xXIOSCARIXx/Web-controlled-RC-car/Showcase/Car.jpg

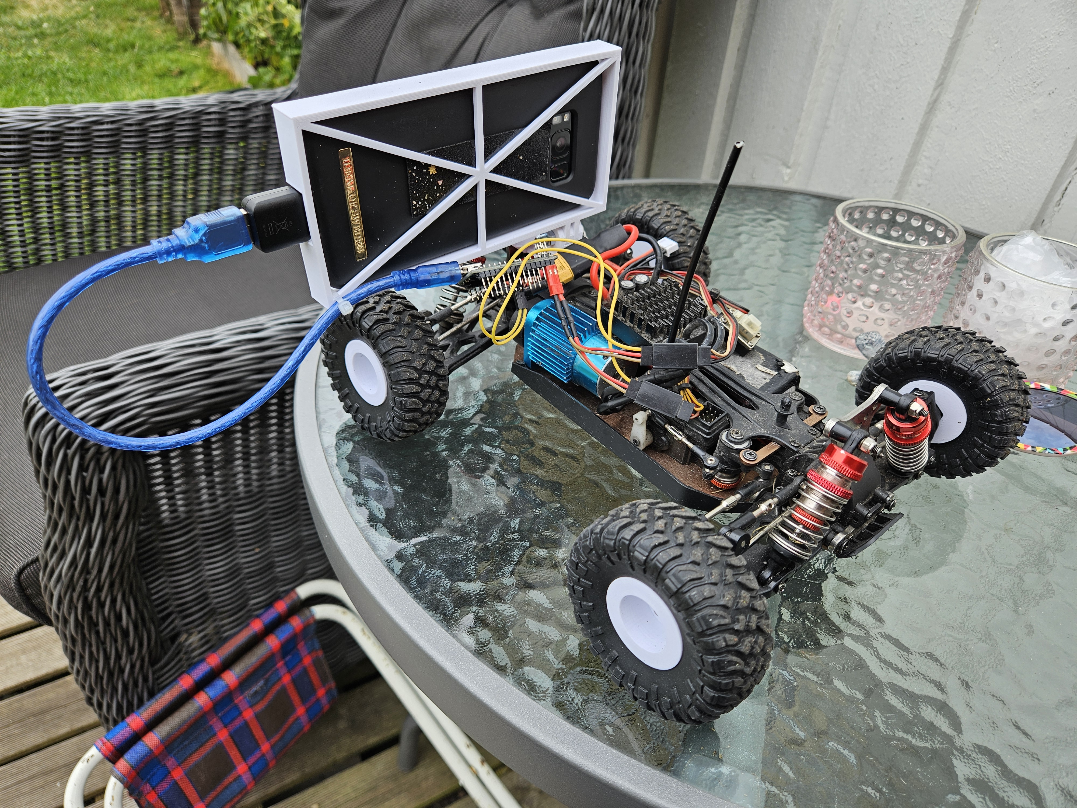
Showcase/Car.jpg
