xXIOSCARIXx/Web-controlled-RC-car/Showcase/UI.jpg

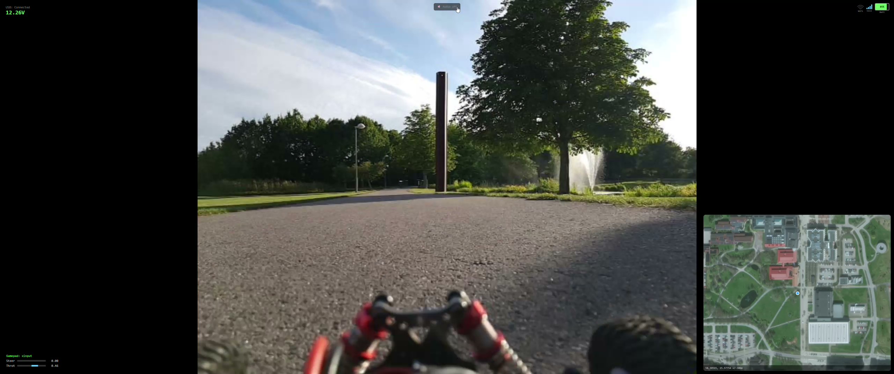
Showcase/UI.jpg
