xXIOSCARIXx/Web-controlled-RC-car/RoverLink/app/src/main/java/com/roverlink/MainService.kt

package com.roverlink

import android.annotation.SuppressLint
import android.util.Range
import android.app.Notification
import android.app.NotificationChannel
import android.app.NotificationManager
import android.app.PendingIntent
import android.content.BroadcastReceiver
import android.content.Context
import android.content.Intent
import android.content.IntentFilter
import android.content.pm.ServiceInfo
import android.view.Surface
import android.hardware.usb.UsbDevice
import android.media.*
import android.hardware.usb.UsbManager
import android.location.Location
import android.net.wifi.WifiManager
import android.os.*
import android.net.ConnectivityManager
import android.net.TrafficStats
import android.net.NetworkCapabilities
import android.net.wifi.WifiInfo
import android.telephony.TelephonyCallback
import android.telephony.SignalStrength
import android.telephony.TelephonyManager
import androidx.camera.camera2.interop.Camera2CameraControl
import androidx.camera.camera2.interop.CaptureRequestOptions
import android.hardware.camera2.CaptureRequest
import androidx.camera.camera2.interop.ExperimentalCamera2Interop
import androidx.camera.core.Camera
import android.util.Size
import androidx.camera.core.CameraSelector
import androidx.camera.core.Preview
import androidx.camera.core.resolutionselector.ResolutionSelector
import androidx.camera.core.resolutionselector.ResolutionStrategy
import androidx.camera.lifecycle.ProcessCameraProvider
import androidx.core.app.NotificationCompat
import androidx.core.content.ContextCompat
import androidx.lifecycle.Lifecycle
import androidx.lifecycle.LifecycleService
import com.google.android.gms.location.FusedLocationProviderClient
import com.google.android.gms.location.LocationCallback
import com.google.android.gms.location.LocationRequest
import com.google.android.gms.location.LocationResult
import com.google.android.gms.location.LocationServices
import com.google.android.gms.location.Priority
import com.hoho.android.usbserial.driver.UsbSerialProber
import okhttp3.OkHttpClient
import okhttp3.Request
import okhttp3.Response
import okhttp3.WebSocket
import okhttp3.WebSocketListener
import okio.ByteString.Companion.toByteString
import org.json.JSONObject
import java.security.KeyStore
import java.security.cert.CertificateFactory
import java.util.concurrent.Executors
import java.util.concurrent.atomic.AtomicReference
import javax.net.ssl.SSLContext
import javax.net.ssl.TrustManagerFactory
import javax.net.ssl.X509TrustManager
import kotlin.math.roundToInt

@androidx.annotation.OptIn(ExperimentalCamera2Interop::class)
class MainService : LifecycleService() {

    private val binder = LocalBinder()
    private var wakeLock: PowerManager.WakeLock? = null

    var wsStatus = "WSS: Connecting..."
        private set
    var usbStatus = "USB: Disconnected"
        private set
    var steerDisplay = 0f
        private set
    var throttleDisplay = 0f
        private set
    var isStreaming = false
        private set

    @Volatile
    private var wasWsConnected = false
    private val appStartTime = SystemClock.uptimeMillis()
    private val statusDelayHandler = Handler(Looper.getMainLooper())
    private var onStatusChanged: (() -> Unit)? = null

    private val batteryReceiver = object : BroadcastReceiver() {
        override fun onReceive(context: Context, intent: Intent) {
            val level = intent.getIntExtra(BatteryManager.EXTRA_LEVEL, -1)
            val scale = intent.getIntExtra(BatteryManager.EXTRA_SCALE, -1)
            val status = intent.getIntExtra(BatteryManager.EXTRA_STATUS, -1)
            val isCharging = status == BatteryManager.BATTERY_STATUS_CHARGING ||
                    status == BatteryManager.BATTERY_STATUS_FULL

            if ((level != -1) && (scale != -1)) {
                val pct = ((level * 100f) / scale).roundToInt()
                webSocket?.send("""{"type":"battery","level":$pct,"charging":$isCharging}""")
            }
        }
    }

    private var wifiLevel = 0
    private var cellLevel = 0
    private var lastUidRx = 0L
    private var lastUidTx = 0L
    private var dataRxSinceStart = 0L
    private var dataTxSinceStart = 0L
    private var signalThread: HandlerThread? = null
    private var signalHandler: Handler? = null
    private val signalRunnable = object : Runnable {
        override fun run() {
            updateSignalInfo()
            updateDataUsage()
            signalHandler?.postDelayed(this, 5000)
        }
    }

    private fun updateDataUsage() {
        val currentRx = TrafficStats.getUidRxBytes(Process.myUid())
        val currentTx = TrafficStats.getUidTxBytes(Process.myUid())
        
        if (currentRx != TrafficStats.UNSUPPORTED.toLong() && currentTx != TrafficStats.UNSUPPORTED.toLong()) {
            if (lastUidRx > 0 || lastUidTx > 0) {
                val deltaRx = if (currentRx >= lastUidRx) currentRx - lastUidRx else 0L
                val deltaTx = if (currentTx >= lastUidTx) currentTx - lastUidTx else 0L
                
                val cm = getSystemService(CONNECTIVITY_SERVICE) as ConnectivityManager
                val network = cm.activeNetwork
                val caps = cm.getNetworkCapabilities(network)
                if (caps != null && (caps.hasTransport(NetworkCapabilities.TRANSPORT_CELLULAR) || 
                    caps.hasTransport(NetworkCapabilities.TRANSPORT_WIFI))) {
                    dataRxSinceStart += deltaRx
                    dataTxSinceStart += deltaTx
                }
            }
            lastUidRx = currentRx
            lastUidTx = currentTx
        }
        
        webSocket?.send("""{"type":"data_usage","data_rx":$dataRxSinceStart,"data_tx":$dataTxSinceStart}""")
    }

    private fun updateSignalInfo() {
        val wm = getSystemService(WIFI_SERVICE) as WifiManager
        val cm = getSystemService(CONNECTIVITY_SERVICE) as ConnectivityManager
        val network = cm.activeNetwork
        val caps = cm.getNetworkCapabilities(network)
        if ((caps != null) && caps.hasTransport(NetworkCapabilities.TRANSPORT_WIFI)) {
            val wifiInfo = if (Build.VERSION.SDK_INT >= Build.VERSION_CODES.S) {
                caps.transportInfo as? WifiInfo
            } else {
                @Suppress("DEPRECATION")
                wm.connectionInfo
            }
            if (wifiInfo != null) {
                wifiLevel = if (Build.VERSION.SDK_INT >= Build.VERSION_CODES.R) {
                    wm.calculateSignalLevel(wifiInfo.rssi)
                } else {
                    @Suppress("DEPRECATION")
                    WifiManager.calculateSignalLevel(wifiInfo.rssi, 5)
                }
                webSocket?.send("""{"type":"wifi","level":$wifiLevel}""")
            }
        } else {
            wifiLevel = 0
        }
    }

    private val telephonyCallback = if (Build.VERSION.SDK_INT >= Build.VERSION_CODES.S) {
        object : TelephonyCallback(), TelephonyCallback.SignalStrengthsListener {
            @Deprecated("Deprecated in Java")
            override fun onSignalStrengthsChanged(signalStrength: SignalStrength) {
                updateSignalLevel(signalStrength)
            }
        }
    } else null

    private val phoneStateListener = if (Build.VERSION.SDK_INT < Build.VERSION_CODES.S) {
        @Suppress("DEPRECATION")
        object : android.telephony.PhoneStateListener() {
            @Deprecated("Deprecated in Java")
            override fun onSignalStrengthsChanged(signalStrength: SignalStrength) {
                updateSignalLevel(signalStrength)
            }
        }
    } else null

    private fun updateSignalLevel(signalStrength: SignalStrength) {
        val level = if (Build.VERSION.SDK_INT >= Build.VERSION_CODES.Q) {
            signalStrength.level
        } else {
            try {
                val getLevel = SignalStrength::class.java.getMethod("getLevel")
                getLevel.invoke(signalStrength) as Int
            } catch (_: Exception) {
                0
            }
        }
        cellLevel = level
        webSocket?.send("""{"type":"cell","level":$cellLevel}""")
    }

    @Volatile
    private var webSocket: WebSocket? = null
    private val client by lazy { buildTrustedClient() }
    private var serverIp = ""
    private val reconnectHandler = Handler(Looper.getMainLooper())
    private val usbReconnectHandler = Handler(Looper.getMainLooper())

    @Volatile
    private var serial: UsbCdcSerial? = null
    private val usbLock = Any()
    private val usbReadExecutor = Executors.newSingleThreadExecutor { r ->
        Thread(r, "UsbReadThread").apply { priority = Thread.MAX_PRIORITY }
    }
    private val usbWriteExecutor = Executors.newSingleThreadExecutor { r ->
        Thread(r, "UsbWriteThread").apply { priority = Thread.MAX_PRIORITY }
    }
    private var lastSteerValue = -1
    private var lastThrottleValue = -1
    private var lastDriveSentAt = 0L
    private val pendingDrive = AtomicReference<Triple<Float, Float, Float>?>()

    private val usbReceiver = object : BroadcastReceiver() {
        override fun onReceive(context: Context, intent: Intent) {
            when (intent.action) {
                ACTION_USB_PERMISSION -> {
                    val granted = intent.getBooleanExtra(UsbManager.EXTRA_PERMISSION_GRANTED, false)
                    if (granted) connectUsb() else updateUsbStatus("USB: Permission denied")
                }
                UsbManager.ACTION_USB_DEVICE_ATTACHED -> connectUsb()
                UsbManager.ACTION_USB_DEVICE_DETACHED -> {
                    val device = if (Build.VERSION.SDK_INT >= Build.VERSION_CODES.TIRAMISU) {
                        intent.getParcelableExtra(UsbManager.EXTRA_DEVICE, UsbDevice::class.java)
                    } else {
                        @Suppress("DEPRECATION")
                        intent.getParcelableExtra(UsbManager.EXTRA_DEVICE)
                    }
                    if ((device == null) || (device.deviceName == (serial?.deviceName ?: "")))
                        closeSerial("USB: Disconnected")
                }
            }
        }
    }

    private lateinit var fusedLocationClient: FusedLocationProviderClient
    private lateinit var locationFilter: LocationFilter
    private var currentBestLocation: Location? = null
    private val locationCallback = object : LocationCallback() {
        override fun onLocationResult(result: LocationResult) {
            val loc: Location = result.lastLocation ?: return
            if (isBetterLocation(loc, currentBestLocation)) {
                currentBestLocation = loc
                val filteredLoc = locationFilter.filter(loc)
                val ws = webSocket ?: return
                val payload = """{"type":"gps","lat":${filteredLoc.latitude},"lng":${filteredLoc.longitude},"acc":${filteredLoc.accuracy}}"""
                ws.send(payload)
            }
        }
    }

    private fun isBetterLocation(location: Location, currentBestLocation: Location?): Boolean {
        if (currentBestLocation == null) {
            return true
        }

        val timeDelta: Long = location.time - currentBestLocation.time
        val isSignificantlyNewer: Boolean = timeDelta > TWO_MINUTES
        val isSignificantlyOlder: Boolean = timeDelta < -TWO_MINUTES
        val isNewer: Boolean = timeDelta > 0

        if (isSignificantlyNewer) {
            return true
        } else if (isSignificantlyOlder) {
            return false
        }

        val accuracyDelta: Int = (location.accuracy - currentBestLocation.accuracy).toInt()
        val isLessAccurate: Boolean = accuracyDelta > 0
        val isMoreAccurate: Boolean = accuracyDelta < 0
        val isSignificantlyLessAccurate: Boolean = accuracyDelta > 200

        val isFromSameProvider: Boolean = location.provider == currentBestLocation.provider

        if (isMoreAccurate) {
            return true
        } else if (isNewer && !isLessAccurate) {
            return true
        } else if (isNewer && !isSignificantlyLessAccurate && isFromSameProvider) {
            return true
        }
        return false
    }

    private var cameraProvider: ProcessCameraProvider? = null
    private var activeCamera: Camera? = null
    private val cameraExecutor = Executors.newSingleThreadExecutor { r ->
        Thread(r, "CameraFrameThread").apply { priority = Thread.MAX_PRIORITY }
    }
    private var useFrontCamera = false

    private var audioEnabled = false
    private var torchEnabled = false
    private var isAlarmPlaying = false

    @Volatile
    private var isShuttingDown = false

    private var videoEncoder: MediaCodec? = null
    private var inputSurface: Surface? = null
    private var encoderWidth = 960
    private var encoderHeight = 720
    private var configBuffer: ByteArray? = null
    private val videoEncoderLock = Any()

    private var audioRecord: AudioRecord? = null
    private var audioThread: Thread? = null
    @Volatile
    private var isAudioRunning = false

    private var mediaPlayer: MediaPlayer? = null
    private var honkPlayer: MediaPlayer? = null

    inner class LocalBinder : Binder() {
        fun getService(): MainService = this@MainService
    }

    override fun onBind(intent: Intent): IBinder {
        super.onBind(intent)
        return binder
    }

    override fun onCreate() {
        super.onCreate()
        lastUidRx = TrafficStats.getUidRxBytes(Process.myUid())
        lastUidTx = TrafficStats.getUidTxBytes(Process.myUid())
        if (lastUidRx == TrafficStats.UNSUPPORTED.toLong()) lastUidRx = 0
        if (lastUidTx == TrafficStats.UNSUPPORTED.toLong()) lastUidTx = 0

        createNotificationChannel()
        val initialStatus = "$wsStatus | CAM: Standby"
        if (Build.VERSION.SDK_INT >= Build.VERSION_CODES.UPSIDE_DOWN_CAKE) {
            startForeground(
                NOTIFICATION_ID,
                createNotification(initialStatus),
                ServiceInfo.FOREGROUND_SERVICE_TYPE_CAMERA or
                        ServiceInfo.FOREGROUND_SERVICE_TYPE_LOCATION or
                        ServiceInfo.FOREGROUND_SERVICE_TYPE_CONNECTED_DEVICE or
                        ServiceInfo.FOREGROUND_SERVICE_TYPE_MICROPHONE,
            )
        } else {
            startForeground(NOTIFICATION_ID, createNotification(initialStatus))
        }

        val pm = getSystemService(POWER_SERVICE) as PowerManager
        wakeLock = pm.newWakeLock(PowerManager.PARTIAL_WAKE_LOCK, "Scout::WakeLock").apply {
            acquire(24 * 60 * 60 * 1000L)
        }

        fusedLocationClient = LocationServices.getFusedLocationProviderClient(this)
        locationFilter = LocationFilter()

        val tm = getSystemService(TELEPHONY_SERVICE) as TelephonyManager
        if (Build.VERSION.SDK_INT >= Build.VERSION_CODES.S) {
            telephonyCallback?.let { tm.registerTelephonyCallback(mainExecutor, it) }
        } else {
            @Suppress("DEPRECATION")
            tm.listen(phoneStateListener, android.telephony.PhoneStateListener.LISTEN_SIGNAL_STRENGTHS)
        }
        signalThread = HandlerThread("SignalThread").apply { start() }
        signalHandler = Handler(signalThread!!.looper)
        signalHandler?.post(signalRunnable)

        val filter = IntentFilter(ACTION_USB_PERMISSION).apply {
            addAction(UsbManager.ACTION_USB_DEVICE_ATTACHED)
            addAction(UsbManager.ACTION_USB_DEVICE_DETACHED)
        }
        ContextCompat.registerReceiver(this, usbReceiver, filter, ContextCompat.RECEIVER_NOT_EXPORTED)
        registerReceiver(batteryReceiver, IntentFilter(Intent.ACTION_BATTERY_CHANGED))
    }

    override fun onStartCommand(intent: Intent?, flags: Int, startId: Int): Int {
        val newIp = intent?.getStringExtra("server_ip") ?: ""
        if (newIp.isNotEmpty() && (newIp != serverIp)) {
            serverIp = newIp
            startStreaming()
        }
        connectUsb()
        startLocationUpdates()
        return super.onStartCommand(intent, flags, startId)
    }

    fun setStatusListener(listener: (() -> Unit)?) {
        onStatusChanged = listener
    }

    private fun updateWsStatus(status: String) {
        if (wsStatus == status) return
        wsStatus = status
        onStatusChanged?.invoke()
        updateNotification()
    }

    private fun updateUsbStatus(status: String) {
        if (usbStatus == status) return
        usbStatus = status
        onStatusChanged?.invoke()
        updateNotification()
        webSocket?.send("""{"type":"usb_status","status":"$usbStatus"}""")
    }

    private fun updateNotification() {
        val camStatus = if (isStreaming) "CAM: Streaming" else "CAM: Standby"
        val manager = getSystemService(NotificationManager::class.java)
        manager.notify(NOTIFICATION_ID, createNotification("$wsStatus | $camStatus"))
    }

    private fun buildTrustedClient(): OkHttpClient {
        val resId = try { R.raw.cert } catch (_: Exception) { 0 }
        if (resId == 0) {
            return OkHttpClient.Builder()
                .hostnameVerifier { _, _ -> true }
                .build()
        }

        val certInputStream = resources.openRawResource(resId)
        val cf = CertificateFactory.getInstance("X.509")
        val cert = cf.generateCertificate(certInputStream)
        certInputStream.close()
        val keyStore = KeyStore.getInstance(KeyStore.getDefaultType()).apply {
            load(null, null)
            setCertificateEntry("server", cert)
        }
        val tmf = TrustManagerFactory.getInstance(TrustManagerFactory.getDefaultAlgorithm()).apply {
            init(keyStore)
        }
        val sslContext = SSLContext.getInstance("TLS").apply {
            init(null, tmf.trustManagers, null)
        }
        val tm = tmf.trustManagers[0] as X509TrustManager
        return OkHttpClient.Builder()
            .sslSocketFactory(sslContext.socketFactory, tm)
            .hostnameVerifier { _, _ -> true }
            .build()
    }

    private fun startStreaming() {
        reconnectHandler.removeCallbacksAndMessages(null)
        webSocket?.close(1000, null)
        webSocket = null

        if (wsStatus == "WSS: Connected") {
            updateWsStatus("WSS: Connecting...")
        }

        val url = if (serverIp.contains(':')) {
            "wss://$serverIp?role=publisher"
        } else {
            "wss://$serverIp:47291?role=publisher"
        }
        val request = Request.Builder().url(url).build()
        val newSocket = client.newWebSocket(
            request,
            object : WebSocketListener() {
                override fun onOpen(webSocket: WebSocket, response: Response) {
                    wasWsConnected = true
                    statusDelayHandler.removeCallbacksAndMessages(null)
                    Handler(Looper.getMainLooper()).post {
                        updateWsStatus("WSS: Connected")
                        
                        val filter = IntentFilter(Intent.ACTION_BATTERY_CHANGED)
                        val batteryStatus = registerReceiver(null, filter)
                        val bLevel = batteryStatus?.getIntExtra(BatteryManager.EXTRA_LEVEL, -1) ?: -1
                        val bScale = batteryStatus?.getIntExtra(BatteryManager.EXTRA_SCALE, -1) ?: -1
                        val bStatus = batteryStatus?.getIntExtra(BatteryManager.EXTRA_STATUS, -1) ?: -1
                        val isCharging = bStatus == BatteryManager.BATTERY_STATUS_CHARGING ||
                                bStatus == BatteryManager.BATTERY_STATUS_FULL

                        if ((bLevel != -1) && (bScale != -1)) {
                            val pct = ((bLevel * 100f) / bScale).roundToInt()
                            webSocket.send("""{"type":"battery","level":$pct,"charging":$isCharging}""")
                        }
                        
                        updateSignalInfo()
                        updateDataUsage()
                        
                        webSocket.send("""{"type":"usb_status","status":"$usbStatus"}""")
                        
                        webSocket.send("""{"type":"audio_status","enabled":$audioEnabled}""")
                        webSocket.send("""{"type":"torch_status","enabled":$torchEnabled}""")
                        webSocket.send("""{"type":"alarm_status","enabled":$isAlarmPlaying}""")
                    }
                }

                override fun onMessage(webSocket: WebSocket, text: String) {
                    val json = try { JSONObject(text) } catch (_: Exception) { return }
                    when (json.optString("type")) {
                        "viewer_count" -> {
                            val hasViewers = json.optInt("count") > 0
                            Handler(Looper.getMainLooper()).post {
                                if (hasViewers && !isStreaming) {
                                    isStreaming = true
                                    bindCamera()
                                    if (audioEnabled) startAudio()
                                } else if (!hasViewers && isStreaming) {
                                    stopStreamingInternal()
                                }
                                onStatusChanged?.invoke()
                                updateNotification()
                            }
                            return
                        }
                        "toggle_camera" -> {
                            useFrontCamera = !useFrontCamera
                            torchEnabled = false
                            webSocket.send("""{"type":"torch_status","enabled":false}""")
                            Handler(Looper.getMainLooper()).post {
                                if (isStreaming) {
                                    cameraProvider?.unbindAll()
                                    stopVideoEncoder()
                                    bindCamera()
                                }
                            }
                            return
                        }
                        "toggle_audio" -> {
                            audioEnabled = !audioEnabled
                            webSocket.send("""{"type":"audio_status","enabled":$audioEnabled}""")
                            Handler(Looper.getMainLooper()).post {
                                if (isStreaming) {
                                    if (audioEnabled) startAudio() else stopAudio()
                                }
                            }
                            return
                        }
                        "toggle_torch" -> {
                            if (!useFrontCamera) {
                                torchEnabled = !torchEnabled
                                activeCamera?.cameraControl?.enableTorch(torchEnabled)
                                webSocket.send("""{"type":"torch_status","enabled":$torchEnabled}""")
                            } else {
                                torchEnabled = false
                                webSocket.send("""{"type":"torch_status","enabled":false}""")
                            }
                            return
                        }
                        "ping" -> {
                            val ts = json.optLong("ts", 0L)
                            val vid = json.optString("_vid", "")
                            webSocket.send("""{"type":"pong","ts":$ts,"_vid":"$vid"}""")
                            return
                        }
                        "play_alarm" -> {
                            Handler(Looper.getMainLooper()).post { playAlarm() }
                            return
                        }
                        "stop_alarm" -> {
                            Handler(Looper.getMainLooper()).post { stopAlarm() }
                            return
                        }
                        "play_honk" -> {
                            Handler(Looper.getMainLooper()).post { playHonk() }
                            return
                        }
                        "stop_honk" -> {
                            Handler(Looper.getMainLooper()).post { stopHonk() }
                            return
                        }
                    }
                    if ((json.optString("type") != "gamepad") || !json.optBoolean("connected")) return
                    val axes = json.optJSONArray("axes")
                    val buttons = json.optJSONArray("buttons")
                    val steerAxis = axes?.optDouble(0)?.toFloat() ?: 0f
                    val l2 = buttons?.optDouble(6)?.toFloat() ?: 0f
                    val r2 = buttons?.optDouble(7)?.toFloat() ?: 0f

                    steerDisplay = steerAxis
                    throttleDisplay = (r2 - l2).coerceIn(-1f, 1f)
                    onStatusChanged?.invoke()

                    pendingDrive.set(Triple(steerAxis, l2, r2))
                    usbWriteExecutor.execute {
                        val args = pendingDrive.getAndSet(null) ?: return@execute
                        sendDrive(args.first, args.second, args.third)
                    }
                }

                override fun onClosed(webSocket: WebSocket, code: Int, reason: String) {
                    if (isShuttingDown || (this@MainService.webSocket !== webSocket)) return
                    Handler(Looper.getMainLooper()).post {
                        stopStreamingInternal()
                        updateWsStatus("WSS: Connection lost, retrying...")
                        scheduleReconnect()
                    }
                }

                override fun onFailure(webSocket: WebSocket, t: Throwable, response: Response?) {
                    if (isShuttingDown || this@MainService.webSocket !== webSocket) return
                    Handler(Looper.getMainLooper()).post {
                        stopStreamingInternal()
                        val now = SystemClock.uptimeMillis()
                        val elapsed = now - appStartTime
                        if (elapsed < 3000L && !wasWsConnected) {
                            statusDelayHandler.removeCallbacksAndMessages(null)
                            statusDelayHandler.postDelayed(
                                {
                                    if (this@MainService.webSocket !== webSocket) return@postDelayed
                                    updateWsStatus("WSS: Unable to connect, retrying...")
                                    scheduleReconnect()
                                },
                                3000L - elapsed,
                            )
                        } else {
                            val msg = if (wasWsConnected) "WSS: Connection lost, retrying..." else "WSS: Unable to connect, retrying..."
                            updateWsStatus(msg)
                            scheduleReconnect()
                        }
                    }
                }
            },
        )
        webSocket = newSocket
    }

    private fun stopStreamingInternal() {
        if (isStreaming) {
            isStreaming = false
            torchEnabled = false
            audioEnabled = false
            webSocket?.send("""{"type":"torch_status","enabled":false}""")
            webSocket?.send("""{"type":"audio_status","enabled":false}""")
        }
        stopAudio()
        cameraProvider?.unbindAll()
        stopVideoEncoder()
        configBuffer = null
        activeCamera = null
        onStatusChanged?.invoke()
        updateNotification()
    }

    private fun scheduleReconnect() {
        if (isShuttingDown) return
        reconnectHandler.removeCallbacksAndMessages(null)
        reconnectHandler.postDelayed({ startStreaming() }, 3000L)
    }

    @SuppressLint("MissingPermission")
    private fun startLocationUpdates() {
        val request = LocationRequest.Builder(Priority.PRIORITY_HIGH_ACCURACY, 1000L)
            .setMinUpdateIntervalMillis(1000L)
            .setWaitForAccurateLocation(true)
            .build()
        fusedLocationClient.requestLocationUpdates(request, locationCallback, Looper.getMainLooper())
    }

    private fun bindCamera() {
        val providerFuture = ProcessCameraProvider.getInstance(this)
        providerFuture.addListener(
            {
                if (!isStreaming || lifecycle.currentState == Lifecycle.State.DESTROYED) return@addListener
                cameraProvider = try { providerFuture.get() } catch (_: Exception) { return@addListener }

                encoderWidth = 960
                encoderHeight = 720
                initVideoEncoder(encoderWidth, encoderHeight)

                val surface = inputSurface ?: return@addListener

                val preview = Preview.Builder()
                    .setResolutionSelector(
                        ResolutionSelector.Builder()
                            .setResolutionStrategy(ResolutionStrategy(Size(encoderWidth, encoderHeight), ResolutionStrategy.FALLBACK_RULE_CLOSEST_HIGHER_THEN_LOWER))
                            .build()
                    )
                    .build()

                preview.setSurfaceProvider(cameraExecutor) { request ->
                    request.provideSurface(surface, cameraExecutor) {
                    }
                }

                val selector = if (useFrontCamera) CameraSelector.DEFAULT_FRONT_CAMERA else CameraSelector.DEFAULT_BACK_CAMERA
                try {
                    cameraProvider?.unbindAll()
                    activeCamera = cameraProvider?.bindToLifecycle(this, selector, preview)
                    activeCamera?.let { camera ->
                        val builder = CaptureRequestOptions.Builder()
                        
                        builder.setCaptureRequestOption(CaptureRequest.CONTROL_AF_MODE, CaptureRequest.CONTROL_AF_MODE_OFF)
                        builder.setCaptureRequestOption(CaptureRequest.LENS_FOCUS_DISTANCE, 0.0f)
                        
                        if (!useFrontCamera) {
                            builder.setCaptureRequestOption(CaptureRequest.LENS_OPTICAL_STABILIZATION_MODE, CaptureRequest.LENS_OPTICAL_STABILIZATION_MODE_ON)
                            builder.setCaptureRequestOption(CaptureRequest.CONTROL_VIDEO_STABILIZATION_MODE, CaptureRequest.CONTROL_VIDEO_STABILIZATION_MODE_ON)
                        }

                        builder.setCaptureRequestOption(CaptureRequest.CONTROL_AE_MODE, CaptureRequest.CONTROL_AE_MODE_ON)
                        builder.setCaptureRequestOption(CaptureRequest.CONTROL_AE_TARGET_FPS_RANGE, Range(24, 30))
                        builder.setCaptureRequestOption(CaptureRequest.CONTROL_AE_EXPOSURE_COMPENSATION, 1)

                        Camera2CameraControl.from(camera.cameraControl).captureRequestOptions = builder.build()
                    }
                } catch (_: Exception) { }
            },
            ContextCompat.getMainExecutor(this),
        )
    }

    private fun initVideoEncoder(width: Int, height: Int) {
        synchronized(videoEncoderLock) {
            if (videoEncoder != null) return
            try {
                val format = MediaFormat.createVideoFormat(MediaFormat.MIMETYPE_VIDEO_AVC, width, height)
                format.setInteger(MediaFormat.KEY_COLOR_FORMAT, MediaCodecInfo.CodecCapabilities.COLOR_FormatSurface)
                format.setInteger(MediaFormat.KEY_BIT_RATE, 4_000_000)
                format.setInteger(MediaFormat.KEY_FRAME_RATE, 30)
                format.setInteger(MediaFormat.KEY_I_FRAME_INTERVAL, 0)
                format.setInteger(MediaFormat.KEY_BITRATE_MODE, MediaCodecInfo.EncoderCapabilities.BITRATE_MODE_VBR)

                format.setInteger(MediaFormat.KEY_LATENCY, 0)
                format.setInteger(MediaFormat.KEY_PRIORITY, 0)

                format.setInteger(MediaFormat.KEY_PROFILE, MediaCodecInfo.CodecProfileLevel.AVCProfileBaseline)
                format.setInteger(MediaFormat.KEY_LEVEL, MediaCodecInfo.CodecProfileLevel.AVCLevel31)

                videoEncoder = MediaCodec.createEncoderByType(MediaFormat.MIMETYPE_VIDEO_AVC)
                videoEncoder?.setCallback(
                    object : MediaCodec.Callback() {
                        override fun onInputBufferAvailable(codec: MediaCodec, index: Int) {}
                    override fun onOutputBufferAvailable(codec: MediaCodec, index: Int, info: MediaCodec.BufferInfo) {
                        val ws = webSocket
                        if ((ws == null) || (ws.queueSize() > 80_000)) {
                            codec.releaseOutputBuffer(index, false)
                            return
                        }
                        val buffer = codec.getOutputBuffer(index) ?: return
                        val data = ByteArray(info.size)
                        buffer.get(data)

                        if ((info.flags and MediaCodec.BUFFER_FLAG_CODEC_CONFIG) != 0) {
                            configBuffer = data
                        } else {
                            val isKeyframe = (info.flags and MediaCodec.BUFFER_FLAG_KEY_FRAME) != 0
                            val config = configBuffer

                            val outputData = if (isKeyframe && config != null) {
                                val combined = ByteArray(config.size + data.size)
                                System.arraycopy(config, 0, combined, 0, config.size)
                                System.arraycopy(data, 0, combined, config.size, data.size)
                                combined
                            } else {
                                data
                            }

                            val prefixed = ByteArray(outputData.size + 1)
                            prefixed[0] = 0x02
                            System.arraycopy(outputData, 0, prefixed, 1, outputData.size)
                            ws.send(prefixed.toByteString())
                        }
                        codec.releaseOutputBuffer(index, false)
                    }
                    override fun onError(codec: MediaCodec, e: MediaCodec.CodecException) {
                        Handler(Looper.getMainLooper()).post { stopStreamingInternal() }
                    }
                    override fun onOutputFormatChanged(codec: MediaCodec, format: MediaFormat) {}
                })
                videoEncoder?.configure(format, null, null, MediaCodec.CONFIGURE_FLAG_ENCODE)
                inputSurface = videoEncoder?.createInputSurface()
                videoEncoder?.start()
            } catch (_: Exception) {
                videoEncoder = null
                inputSurface = null
            }
        }
    }

    private fun stopVideoEncoder() {
        synchronized(videoEncoderLock) {
            try {
                videoEncoder?.stop()
                videoEncoder?.release()
            } catch (_: Exception) {}
            videoEncoder = null
            inputSurface?.release()
            inputSurface = null
        }
    }

    @SuppressLint("MissingPermission")
    private fun startAudio() {
        if (isAudioRunning) return
        val bufferSize = AudioRecord.getMinBufferSize(16000, AudioFormat.CHANNEL_IN_MONO, AudioFormat.ENCODING_PCM_16BIT)
        if (bufferSize <= 0) return

        audioRecord = AudioRecord(MediaRecorder.AudioSource.MIC, 16000, AudioFormat.CHANNEL_IN_MONO, AudioFormat.ENCODING_PCM_16BIT, bufferSize * 2)
        if (audioRecord?.state != AudioRecord.STATE_INITIALIZED) return

        isAudioRunning = true
        audioThread = Thread(
            {
                val audioBuffer = ByteArray(1024)
                val sendBuffer = ByteArray(audioBuffer.size + 1)
                sendBuffer[0] = 0x01

                try {
                    audioRecord?.startRecording()
                    while (isAudioRunning && !isShuttingDown) {
                        val read = audioRecord?.read(audioBuffer, 0, audioBuffer.size) ?: 0
                        if (read > 0) {
                            val ws = webSocket
                            if (ws != null && ws.queueSize() < 50_000) {
                                System.arraycopy(audioBuffer, 0, sendBuffer, 1, read)
                                ws.send(sendBuffer.toByteString(0, read + 1))
                            }
                        }
                    }
                } catch (_: Exception) {
                }
            },
            "MicStreamThread",
        ).apply {
            priority = Thread.MAX_PRIORITY
            start()
        }
    }

    private fun stopAudio() {
        isAudioRunning = false
        try {
            audioRecord?.stop()
            audioRecord?.release()
        } catch (_: Exception) {}
        audioRecord = null
        audioThread = null
    }

    private fun playAlarm() {
        stopAlarm()
        try {
            mediaPlayer = MediaPlayer.create(this, R.raw.alarm).apply {
                isLooping = true
                start()
            }
            isAlarmPlaying = true
            webSocket?.send("""{"type":"alarm_status","enabled":true}""")
        } catch (_: Exception) {
        }
    }

    private fun stopAlarm() {
        try {
            mediaPlayer?.stop()
            mediaPlayer?.release()
        } catch (_: Exception) {}
        mediaPlayer = null
        isAlarmPlaying = false
        webSocket?.send("""{"type":"alarm_status","enabled":false}""")
    }

    private fun playHonk() {
        stopHonk()
        try {
            honkPlayer = MediaPlayer.create(this, R.raw.honk).apply {
                isLooping = true
                start()
            }
        } catch (_: Exception) {
        }
    }

    private fun stopHonk() {
        try {
            honkPlayer?.stop()
            honkPlayer?.release()
        } catch (_: Exception) {}
        honkPlayer = null
    }

    private fun connectUsb() {
        if (isShuttingDown) return
        usbReconnectHandler.removeCallbacksAndMessages(null)
        val manager = getSystemService(USB_SERVICE) as UsbManager
        val driver = UsbSerialProber.getDefaultProber().findAllDrivers(manager).firstOrNull()
        if (driver == null) { updateUsbStatus("USB: Disconnected"); scheduleUsbReconnect(); return }
        val device = driver.device
        if (serial?.deviceName == device.deviceName) return
        if (manager.hasPermission(device)) { openSerial(device); return }
        updateUsbStatus("USB: Requesting permission")
        val pi = PendingIntent.getBroadcast(this, 0, Intent(ACTION_USB_PERMISSION).setPackage(packageName), PendingIntent.FLAG_MUTABLE)
        manager.requestPermission(device, pi)
    }

    private fun openSerial(device: UsbDevice) {
        synchronized(usbLock) {
            closeSerial(null)
            val manager = getSystemService(USB_SERVICE) as UsbManager
            val port = UsbCdcSerial.open(manager, device, BAUD_RATE)
            if (port == null) { updateUsbStatus("USB: Open failed"); return }
            serial = port
        }
        lastSteerValue = -1
        lastThrottleValue = -1
        updateUsbStatus("USB: Connected")
        serial?.let { startAckReader(it) }
    }

    private fun closeSerial(status: String?) {
        synchronized(usbLock) {
            val port = serial
            serial = null
            port?.close()
            status?.let { newStatus ->
                updateUsbStatus(newStatus)
                if (newStatus.contains("failed") || newStatus.contains("Disconnected")) { scheduleUsbReconnect() }
                else { usbReconnectHandler.removeCallbacksAndMessages(null) }
            }
        }
    }

    private fun scheduleUsbReconnect() {
        if (isShuttingDown) return
        usbReconnectHandler.removeCallbacksAndMessages(null)
        usbReconnectHandler.postDelayed({ if (serial == null) connectUsb() }, 2000L)
    }

    private fun startAckReader(port: UsbCdcSerial) {
        usbReadExecutor.execute {
            val buffer = ByteArray(1024)
            var bytesRead = 0
            while (serial === port) {
                val tempBuffer = ByteArray(256)
                val count = try { port.read(tempBuffer, READ_TIMEOUT_MS) } catch (_: Exception) { return@execute }
                if (count > 0) {
                    if (bytesRead + count > buffer.size) { bytesRead = 0 }
                    System.arraycopy(tempBuffer, 0, buffer, bytesRead, count)
                    bytesRead += count
                    var i = 0
                    while (i <= bytesRead - 3) {
                        if (buffer[i] == 'B'.code.toByte()) {
                            val batHigh = buffer[i + 1].toInt() and 0xFF
                            val batLow = buffer[i + 2].toInt() and 0xFF
                            val batMv = (batHigh shl 8) or batLow
                            webSocket?.send("""{"type":"car_battery","mv":$batMv}""")
                            i += 3
                        } else { i++ }
                    }
                    if (i > 0) { System.arraycopy(buffer, i, buffer, 0, bytesRead - i); bytesRead -= i }
                }
            }
        }
    }

    private fun sendDrive(steerAxis: Float, l2: Float, r2: Float) {
        val port = serial ?: return
        val throttleAxis = (r2 - l2).coerceIn(-1f, 1f)
        val steerByte = (((steerAxis + 1f) / 2f) * 255f).roundToInt().coerceIn(0, 255)
        val throttleByte = (((throttleAxis + 1f) / 2f) * 255f).roundToInt().coerceIn(0, 255)
        val now = SystemClock.uptimeMillis()
        if (((steerByte == lastSteerValue) && (throttleByte == lastThrottleValue)) && ((now - lastDriveSentAt) < DRIVE_KEEPALIVE_MS)) return
        val checksum = (steerByte xor throttleByte xor 0xFF).toByte()
        val ok = port.write(byteArrayOf(COMMAND_DRIVE, steerByte.toByte(), throttleByte.toByte(), checksum))
        if (ok) {
            lastSteerValue = steerByte
            lastThrottleValue = throttleByte
            lastDriveSentAt = now
        } else {
            Handler(Looper.getMainLooper()).post { closeSerial("USB: Write failed") }
        }
    }

    private fun createNotificationChannel() {
        val channel = NotificationChannel(CHANNEL_ID, "Scout Service", NotificationManager.IMPORTANCE_LOW)
        val manager = getSystemService(NotificationManager::class.java)
        manager.createNotificationChannel(channel)
    }

    private fun createNotification(content: String): Notification {
        val pendingIntent = PendingIntent.getActivity(this, 0, Intent(this, MainActivity::class.java), PendingIntent.FLAG_IMMUTABLE)
        return NotificationCompat.Builder(this, CHANNEL_ID)
            .setContentTitle("Scout Active")
            .setContentText(content)
            .setSmallIcon(R.mipmap.ic_launcher)
            .setContentIntent(pendingIntent)
            .build()
    }

    override fun onDestroy() {
        isShuttingDown = true
        reconnectHandler.removeCallbacksAndMessages(null)
        usbReconnectHandler.removeCallbacksAndMessages(null)
        statusDelayHandler.removeCallbacksAndMessages(null)
        stopForeground(STOP_FOREGROUND_REMOVE)
        super.onDestroy()
        wakeLock?.release()
        signalHandler?.removeCallbacks(signalRunnable)
        signalThread?.quitSafely()
        val tm = getSystemService(TELEPHONY_SERVICE) as TelephonyManager
        if (Build.VERSION.SDK_INT >= Build.VERSION_CODES.S) {
            telephonyCallback?.let { tm.unregisterTelephonyCallback(it) }
        } else {
            @Suppress("DEPRECATION")
            tm.listen(phoneStateListener, android.telephony.PhoneStateListener.LISTEN_NONE)
        }
        unregisterReceiver(batteryReceiver)
        fusedLocationClient.removeLocationUpdates(locationCallback)
        cameraProvider?.unbindAll()
        stopAudio()
        stopVideoEncoder()
        stopAlarm()
        stopHonk()
        webSocket?.close(1000, null)
        webSocket = null
        serial?.write(byteArrayOf(COMMAND_CENTER))
        closeSerial(null)
        unregisterReceiver(usbReceiver)
        cameraExecutor.shutdownNow()
        usbReadExecutor.shutdownNow()
        usbWriteExecutor.shutdownNow()
    }

    companion object {
        const val TWO_MINUTES = 1000 * 60 * 2
        const val CHANNEL_ID = "scout_service"
        const val NOTIFICATION_ID = 1
        const val ACTION_USB_PERMISSION = "com.roverlink.USB_PERMISSION"
        const val BAUD_RATE = 115200
        const val READ_TIMEOUT_MS = 20
        const val DRIVE_KEEPALIVE_MS = 200L
        const val COMMAND_DRIVE = 'D'.code.toByte()
        const val COMMAND_CENTER = 'C'.code.toByte()
    }
}
