xXIOSCARIXx/Web-controlled-RC-car/(commit log)

2026-07-28 Arduino nano firmware
    Atmega328 CH340 (Arduino clone)
2026-07-30 Switch camera on command
2026-07-30 Press B to switch camera (Gamepad)
2026-07-30 Steering smoothing and speed limit
